klaussnd/rc-light/hardware/rc_light.kicad_pcb

## KiCad design hardware/rc_light.kicad_pcb (2024-05-26)

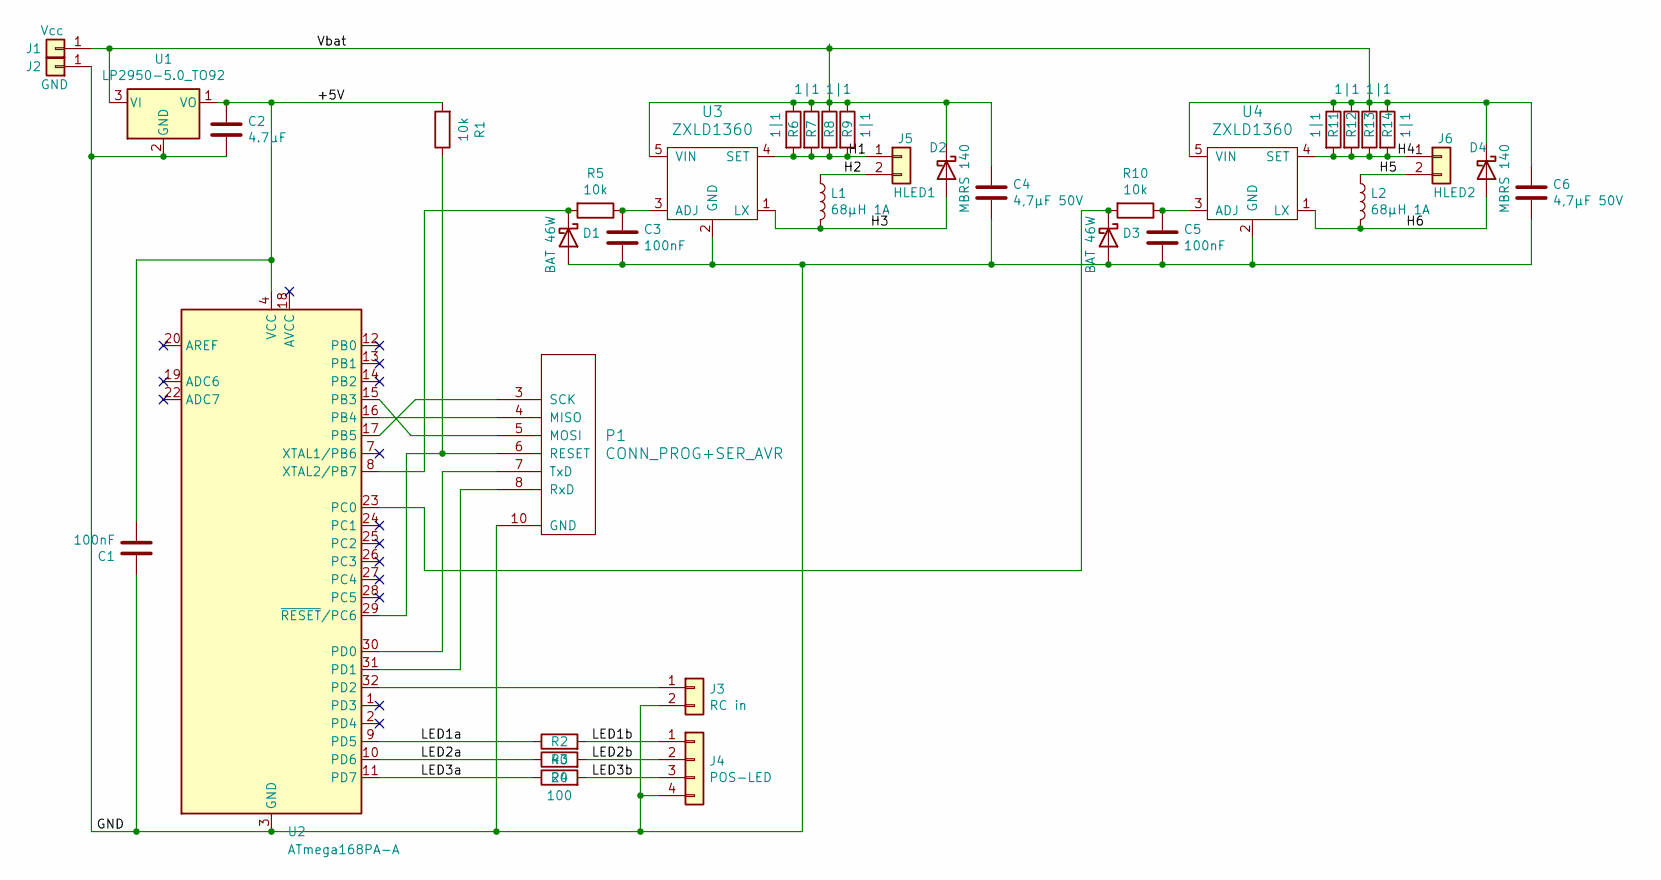
[picture p3: schematic rc_light.kicad_sch, RC plane light]

Parts:
C1, C3, C5: 100nF; C_0805_2012Metric
C2: 4.7µF; C_0805_2012Metric
C4, C6: 4,7µF 50V; C_1206_3216Metric
D1, D3: BAT 46W; D_SOD-123
D2, D4: MBRS 140; 403A
J1: Vcc; PIN_SMD
J2: GND; PIN_SMD
J3: RC in; PinSocket_1x02_P2.54mm_Vertical
J4: POS-LED; PinSocket_1x04_P2.54mm_Vertical
J5: HLED1; PinSocket_1x02_P2.54mm_Vertical
J6: HLED2; PinSocket_1x02_P2.54mm_Vertical
L1, L2: 68µH 1A; L-PISG
P1: CONN_PROG+SER_AVR; SIL-10_MYAVR+SER
R1, R5, R10: 10k; R_0805_2012Metric
R2: 40; R_0805_2012Metric
R3: 20; R_0805_2012Metric
R4: 100; R_0805_2012Metric
R6, R7, R8, R9, R11, R12, R13, R14: 1|1; R_0805_2012Metric
U1: LP2950-5.0_TO92; TO-92_HandSolder
U2: ATmega168PA-A; TQFP-32_7x7mm_P0.8mm
U3, U4: ZXLD1360; TSOT-23-5_HandSoldering

Connections:
/+5V: C1.2, C2.1, R1.2, U1.1 (VO), U2.4 (VCC), U2.6 (VCC)
/GND: C1.1, C2.2, C3.2, C4.2, C5.2, C6.2, D1.2 (A), D3.2 (A), J2.1, J3.2, J4.4, P1.10 (GND), U1.2 (GND), U2.3 (GND), U2.5 (GND), U2.21 (GND), U3.2 (GND), U4.2 (GND)
/H1: J5.1, R6.2, R7.2, R8.2, R9.2, U3.4 (SET)
/H2: J5.2, L1.1
/H3: D2.2 (A), L1.2, U3.1 (LX)
/H4: J6.1, R11.2, R12.2, R13.2, R14.2, U4.4 (SET)
/H5: J6.2, L2.1
/H6: D4.2 (A), L2.2, U4.1 (LX)
/LED1a: R2.1, U2.9 (PD5)
/LED1b: J4.1, R2.2
/LED2a: R3.1, U2.10 (PD6)
/LED2b: J4.2, R3.2
/LED3a: R4.1, U2.11 (PD7)
/LED3b: J4.3, R4.2
/Vbat: C4.1, C6.1, D2.1 (K), D4.1 (K), J1.1, R6.1, R7.1, R8.1, R9.1, R11.1, R12.1, R13.1, R14.1, U1.3 (VI), U3.5 (VIN), U4.5 (VIN)
unnamed: C3.1, R5.1, U3.3 (ADJ)
unnamed: C5.1, R10.1, U4.3 (ADJ)
unnamed: D1.1 (K), R5.2, U2.8 (XTAL2/PB7)
unnamed: D3.1 (K), R10.2, U2.23 (PC0)
unnamed: J3.1, U2.32 (PD2)
unnamed: P1.3 (SCK), U2.17 (PB5)
unnamed: P1.4 (MISO), U2.16 (PB4)
unnamed: P1.5 (MOSI), U2.15 (PB3)
unnamed: P1.6 (RESET), R1.1, U2.29 (~RESET/PC6)
unnamed: P1.7 (TxD), U2.30 (PD0)
unnamed: P1.8 (RxD), U2.31 (PD1)

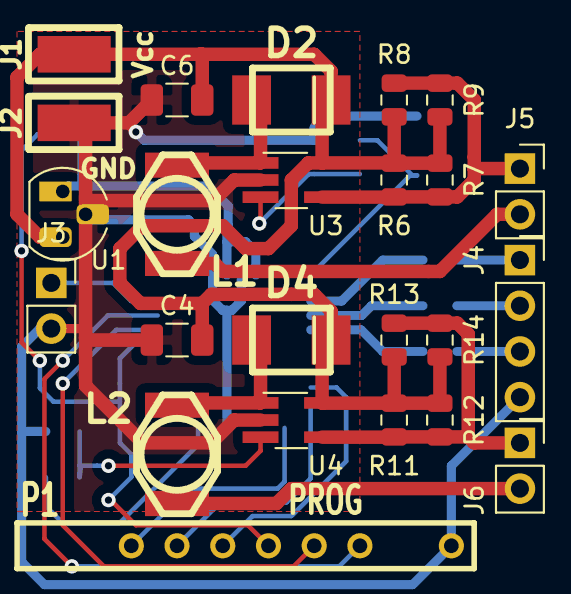
[picture p4: board rc_light.kicad_pcb from above]

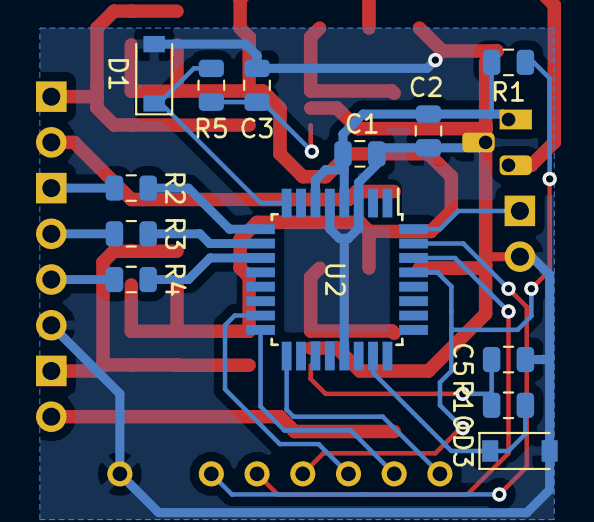
[picture p5: board rc_light.kicad_pcb from below]

Board: 2 copper layers, 37 parts (13 on the bottom side), 26 nets.
