klaussnd/rc-light/(notices)

Notices in the files:
firmware/decode_servo.cpp:
This program is free software; you can redistribute it and/or modify
it under the terms of the GNU General Public License version 3
firmware/rc_light.cpp:
it under the terms of the GNU Affero General Public License version 3
